fischermoseley/GPSDO/Eagle/GPSDOXCO.sch

## EAGLE design Eagle/GPSDOXCO.sch (2019-06-09)

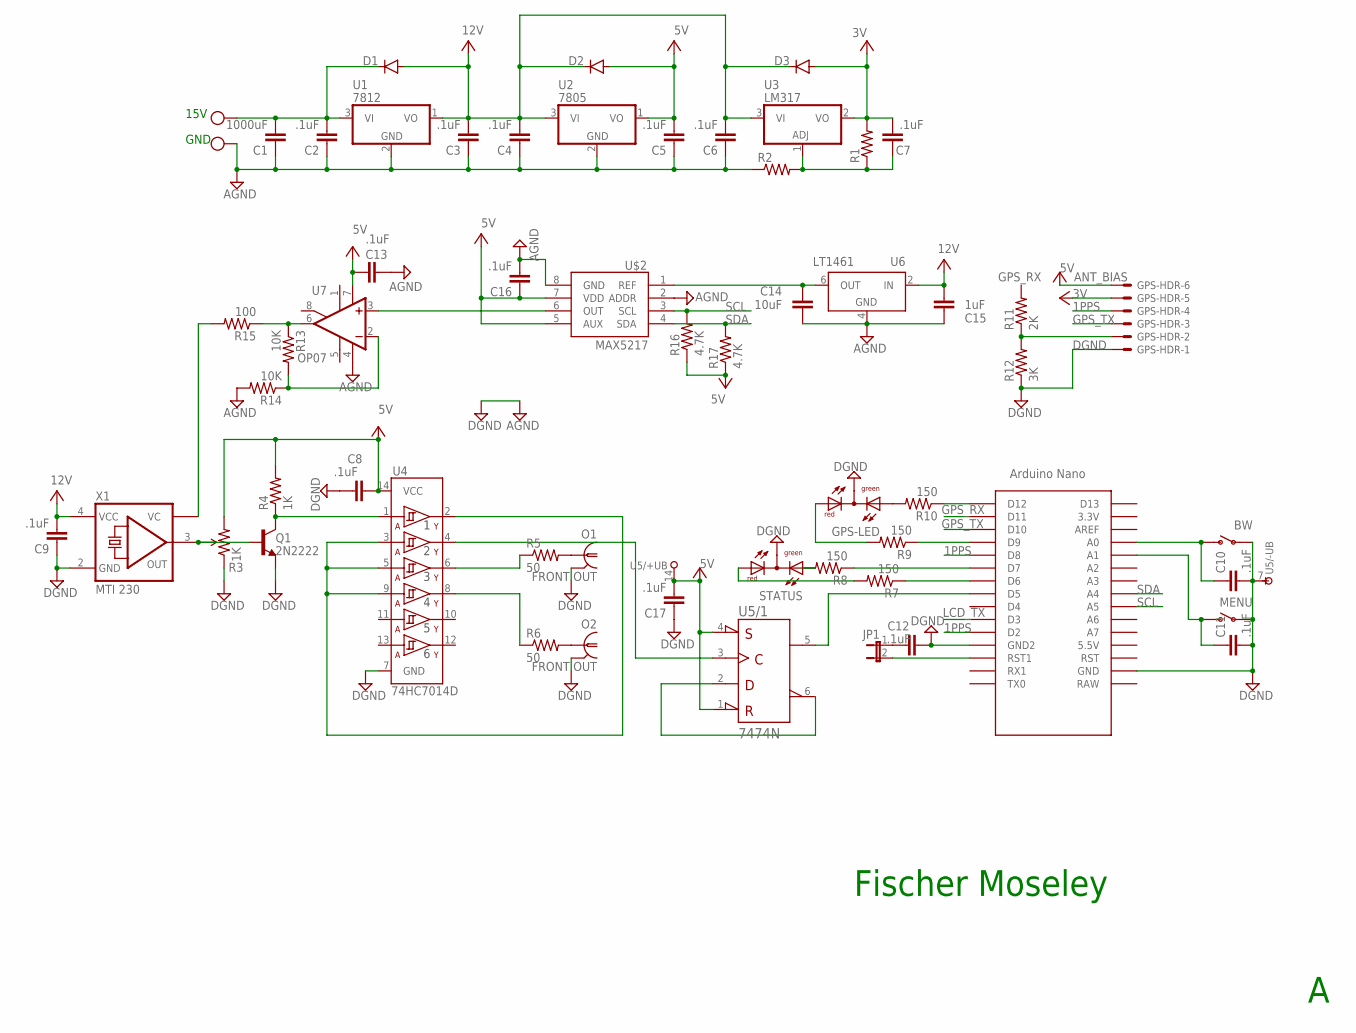
[picture p5: schematic GPSDOXCO.sch]

Parts:
+15V: +15; AK300/2
BW: SWITCH-SPST-2RA; R_SW_TH
C1: 1000uF; C2.5-2
C2, C3, C4, C5, C6, C7, C8, C9, C10, C11, C12, C13, C16, C17: .1uF; C2.5-2
C14: 10uF; C2.5-2
C15: 1uF; C2.5-2
D1, D2, D3: DIODEBAS16; SOD-323
GPS-HDR: 22-23-2061
GPS-LED: DUOLED-RG-C; DUOLED-C-5MM
JP1: JUMPER-2PTH_LOCK; 1X02_LOCK
MENU: SWITCH-SPST-2RA; R_SW_TH
O1, O2: FRONT OUT; R141426
Q1: 2N2222; TO18
R1, R2: RESISTOR0402-RES; 0402-RES
R3: 1K; TRIMPOT-5MM-V2
R4: 1K; 0402-RES
R5, R6: 50; 0402-RES
R7, R8, R9, R10: 150; 0402-RES
R11: 2K; 0402-RES
R12: 3K; 0402-RES
R13, R14: 10K; 0402-RES
R15: 100; 0402-RES
R16, R17: 4.7K; 0402-RES
STATUS: DUOLED-RG-C; DUOLED-C-5MM
U1: 7812; TO92
U2: 7805; TO92
U3: LM317; TO92
U4: 74HC7014D; SOIC-14
U5: 7474N; DIL14
U6: LT1461; DIL08
U7: OP07; TO99
U$1: NANO
U$2: MAX5217; MSOP-8
X1: MTI 230; 7.0X5.0-4-PAD

Connections:
1PPS: GPS-HDR.4, U$1.D2, U$1.D8
3V: C7.2, D3.A, R1.2, U3.2 (VO)
5MHZ_MCU: U5.5 (Q), U$1.D5
5V: C5.2, D2.A, U2.1 (VO)
+3V3: GPS-HDR.5
+5V: C8.2, C13.1, C16.1, C17.2, R3.C (CW), R4.2, R16.1, R17.1, U4.14 (VCC), U5.1 (!CLR), U5.4 (!PRE), U5.14 (+UB), U7.7 (V+), U$2.5 (AUX), U$2.7 (VDD)
AGND: +15V.2, C1.1, C2.1, C3.1, C4.1, C5.1, C6.1, C13.2, C14.1, C15.2, C16.2, R2.1, R14.2, U1.2 (GND), U2.2 (GND), U6.4 (GND), U7.4 (V-), U$2.2 (ADDR), U$2.8 (GND)
ANT_BIAS: GPS-HDR.6
DGND: BW.P$4, C8.1, C9.1, C10.2, C11.2, C12.2, C17.1, GPS-HDR.1, GPS-LED.C, MENU.P$4, O1.2, O2.2, Q1.1 (E), R3.A (CCW), R12.1, STATUS.C, U4.7 (GND), U5.7 (-UB), U$1.GND, U$1.GND1 (GND2), X1.2 (GND)
GPS_RX: GPS-HDR.2, R11.1, R12.2, U$1.D11
GPS_TX: GPS-HDR.3, U$1.D10
LCD_TX: U$1.D3
unnamed: R5.1, U4.6 (3Y)
unnamed: C7.1, R1.1, R2.2, U3.1 (ADJ)
unnamed: +15V.1, C1.2, C2.2, D1.C, U1.3 (VI)
unnamed: Q1.3 (C), R4.1, U4.1 (1A)
unnamed: U4.2 (1Y), U4.3 (2A), U4.5 (3A), U4.9 (4A)
unnamed: R6.1, U4.8 (4Y)
unnamed: U4.4 (2Y), U5.3 (CLK)
unnamed: O1.1, R5.2
unnamed: O2.1, R6.2
unnamed: U5.2 (D), U5.6 (!Q)
unnamed: R15.2, X1.1 (VC)
unnamed: R10.1, U$1.D12
unnamed: R9.1, U$1.D9
unnamed: R7.1, U$1.D6
unnamed: R8.1, U$1.D7
unnamed: GPS-LED.AX (AG), R10.2
unnamed: GPS-LED.AR, R9.2
unnamed: R8.2, STATUS.AX (AG)
unnamed: R7.2, STATUS.AR
unnamed: C12.1, JP1.1
unnamed: C11.1, MENU.P$3 (O), U$1.A1
unnamed: BW.P$3 (O), C10.1, U$1.A0
unnamed: U7.3 (+IN), U$2.6 (OUT)
unnamed: JP1.2, U$1.RST1
unnamed: R13.1, R15.1, U7.6 (OUT)
unnamed: R13.2, R14.1, U7.2 (-IN)
unnamed: C14.2, U6.6 (OUT), U$2.1 (REF)
R3: Q1.2 (B), R3.B (WIPER), X1.3 (OUT)
SCL: R16.2, U$1.A5, U$2.3 (SCL)
SDA: R17.2, U$1.A4, U$2.4 (SDA)
V+: C3.2, C4.2, C6.2, C9.2, C15.1, D1.A, D2.C, D3.C, U1.1 (VO), U2.3 (VI), U3.3 (VI), U6.2 (IN), X1.4 (VCC)

Notes on the sheet:
GND
15V
Fischer Moseley
